jk1mly/pcb-rfsw/README.md

SkyworksのSKY13453-385LFを使うための基板
パッケージが1mm角と小さいデバイスだが、手半田（リフローしない）で付けられるようパッドを工夫
IC以外はチップ部品せず、デバイスが半田できるか試す＋使い方の確認用
