jk1mly/pcb-rfsw/rfsw.pdf

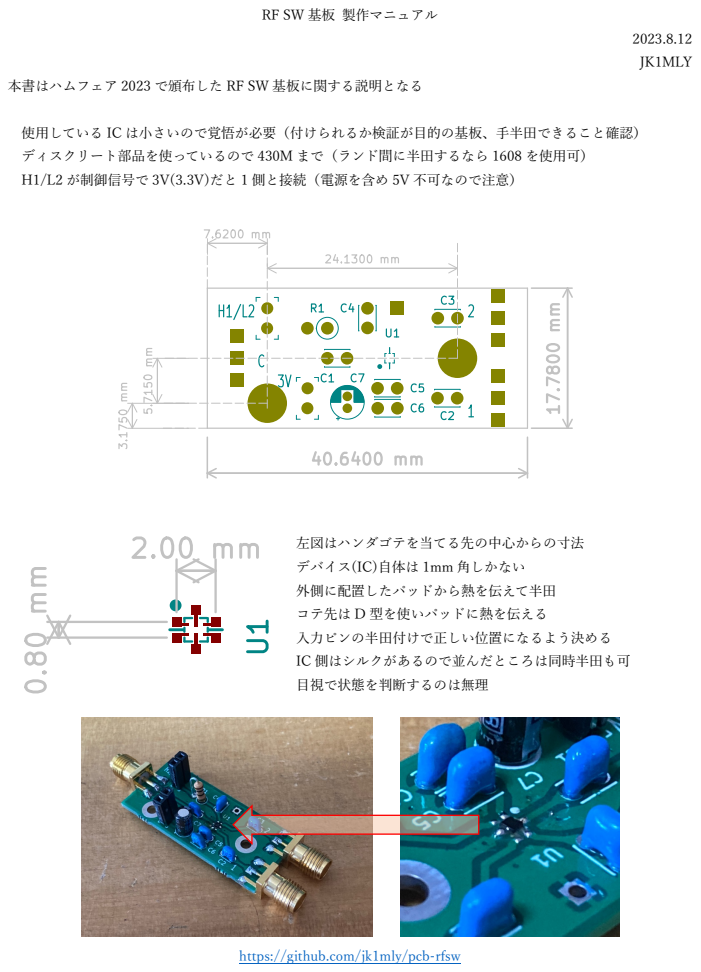
[picture p1: page 1]
JK1MLY

RF SW 基板 製作マニュアル

本書はハムフェア 2023 で頒布した RF SW 基板に関する説明となる

使⽤している IC は⼩さいので覚悟が必要（付けられるか検証が⽬的の基板、⼿半⽥できること確認）
ディスクリート部品を使っているので 430M まで（ランド間に半⽥するなら 1608 を使⽤可）
H1/L2 が制御信号で 3V(3.3V)だと 1 側と接続（電源を含め 5V 不可なので注意）

左図はハンダゴテを当てる先の中⼼からの⼨法
デバイス(IC)⾃体は 1mm ⾓しかない
外側に配置したパッドから熱を伝えて半⽥
コテ先は D 型を使いパッドに熱を伝える
⼊⼒ピンの半⽥付けで正しい位置になるよう決める
IC 側はシルクがあるので並んだところは同時半⽥も可
⽬視で状態を判断するのは無理

https://github.com/jk1mly/pcb-rfsw
