jk1mly/pcb-rfsw/mod-sw1.kicad_pcb

## KiCad design mod-sw1.kicad_pcb (2023-08-12)

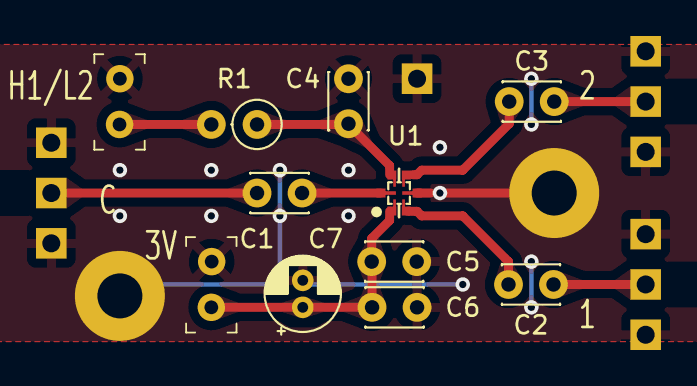
[picture p2: board mod-sw1.kicad_pcb from above]

Board: 2 copper layers, 23 parts (0 on the bottom side), 10 nets.

Parts:
C1, C2, C3, C4, C5, C6: C; C_Disc_D3.0mm_W2.0mm_P2.50mm
C7: 10u; CP_Radial_D4.0mm_P1.50mm
J1, J2, J3, J4, J5, J6: Conn_01x01_Pin; PinHeader_1x01
J7, J8, J9, J10: G; PinHeader_1x01
J11, J12: Conn_01x02_Male; PinHeader_1x2_P2.54mm
R1: 10; R_Axial_DIN0207_L6.3mm_D2.5mm_P2.54mm_Vertical
TP1, TP2: TestPoint; MountingHole_2.5mm_Pad
U1: SKY13453-385LF; QFN6_1x1mm

Connections:
+5V: C5.1, C6.1, C7.1, J12.1, U1.1 (VDD)
GND: C4.2, C5.2, C6.2, C7.2, J2.1, J4.1, J6.1, J7.1, J8.1, J9.1, J10.1, J11.2, J12.2, TP1.1, TP2.1, U1.3 (GND)
unnamed: C1.1, J1.1
unnamed: C2.1, J3.1
unnamed: C3.2, J5.1
unnamed: J11.1, R1.2
unnamed: C2.2, U1.2 (RF1)
unnamed: C3.1, U1.4 (RF2)
unnamed: C1.2, U1.6 (RFC)
unnamed: C4.1, R1.1, U1.5 (VCTL)
